diazmanuel/Nixie-Clock/Hardware/LED White Balance/WB-QBLP650.xlsx

Sheet: White balance
Datos del diseño
Vin (V) | 12
Lv Red (mcd) | 50
Tolerancia de las resistencias | 1%
Resultados
Lv Red [mcd] | 50
Lv Green [mcd] | 94.01363765
Lv Blue [mcd] | 13.44107946
If Red [mA] | 7.414908738
If Green [mA] | 2.053284319
If Blue [mA] | 2.033104411
Vf Red [V] | 2.266566315
Vf Green [V] | 2.287109717
Vf Blue [V] | 2.6160066
If White[mA] | 11.50129747
Pot White [mW] | 26.82108345
Lv White [mcd] | 157.4547171
Res Red [Ω] | 1312.684219
Res Green [Ω] | 4730.416626
Res Blue [Ω] | 4615.598368
Res N Red [Ω] | 1300
Res N Green [Ω] | 4750
Res N Blue [Ω] | 4640

Sheet: Datos Led
LED QBLP650 | If[mA] | Vf[V] | LAMDA[nm] | Iv[mcd]
Red | 20 | 2 | 620 | 140
True Green | 20 | 3.4 | 525 | 500
Blue | 20 | 3.1 | 470 | 100
 | Curva If-Vf |  |  |  |  | Curva If-Vf
if vs Vf | Red | Green | Blue |  | Lv vs If | Red | Green | Blue
If[mA] | Vf[V] | Vf[V] | Vf[V] |  | Relative Lv | If[mA] | If[mA] | If[mA]
0.1 | 1.8 | 1.8 | 1.8 |  | 0.01 | 0.01 | 0.01 | 0.01
1 | 1.96 | 2.1 | 2.68 |  | 0.1 | 2.45 | 1 | 1.55
2 | 2.07 | 2.42 | 2.8 |  | 0.2 | 4.45 | 2.19 | 3
3 | 2.14 | 2.47 | 2.85 |  | 0.3 | 6.32 | 3.42 | 4.77
4 | 2.17 | 2.54 | 2.87 |  | 0.4 | 8.26 | 4.9 | 6.71
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
