diazmanuel/Nixie-Clock/Software/NixieClock/Yakindu/nixie.png

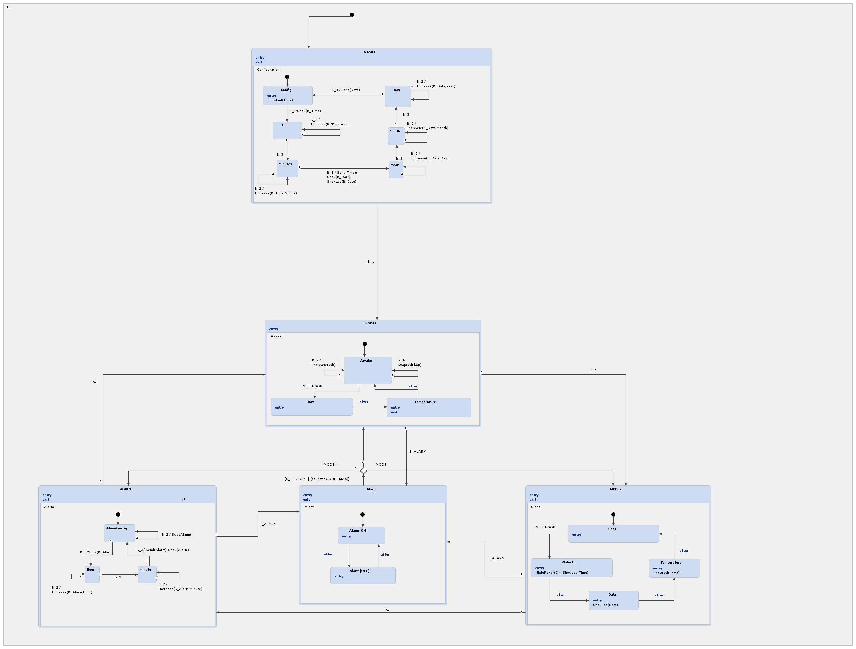
Software/NixieClock/Yakindu/nixie.png
