diazmanuel/Nixie-Clock/Hardware/3D Models/SW18 Parts/NixieClock.SLDASM

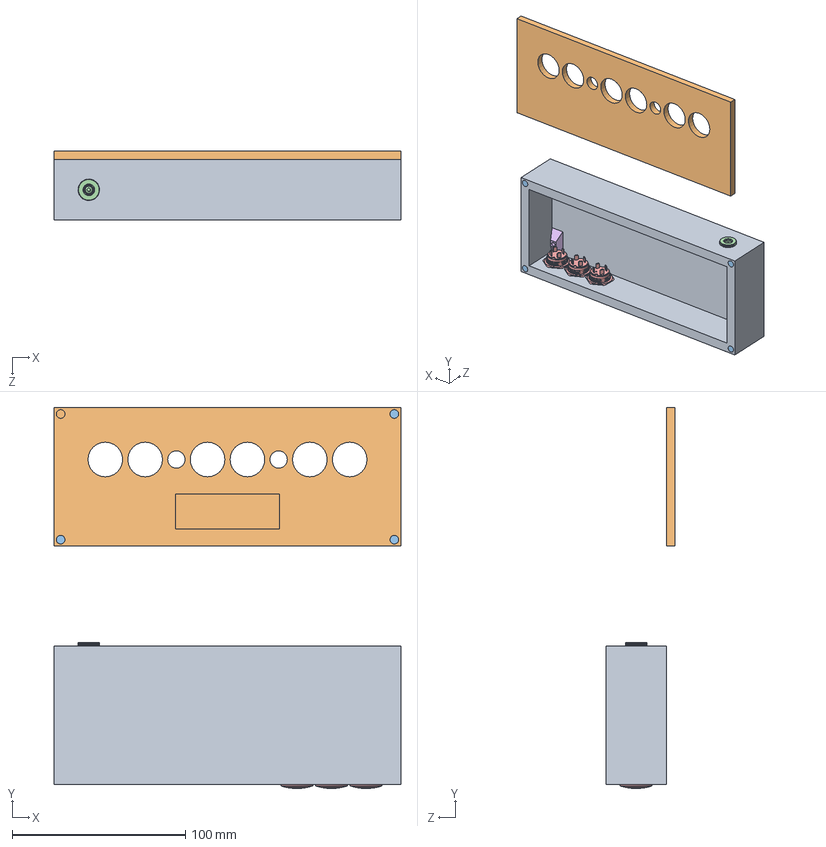
[picture p2: CAD file, 2020-05-14]
Hardware/3D Models/SW18 Parts/NixieClock.SLDASM
200.0 x 219.8 x 40.0 mm
caja
Acrilico
Iman x 8
Jack5.5x2.1
Button x 3
Pata x 2
