diazmanuel/Nixie-Clock/Hardware/3D Models/3D Print/Leg.STL

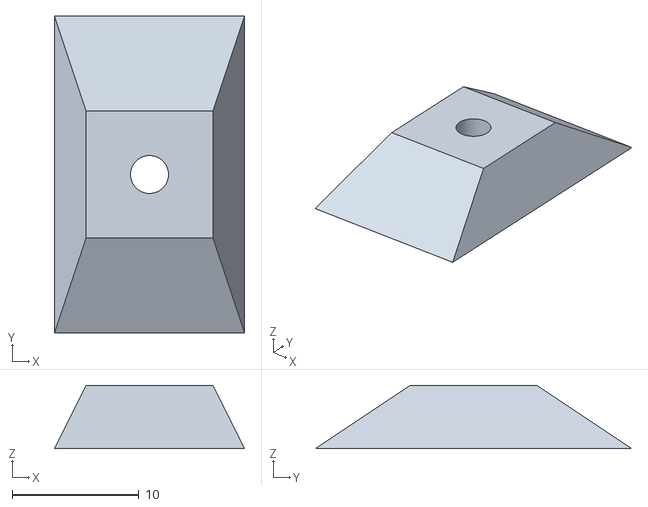
[picture p3: CAD file, 2021-12-26]
Hardware/3D Models/3D Print/Leg.STL
15.0 x 25.0 x 5.00
