diazmanuel/Nixie-Clock/Hardware/3D Models/SW18 Parts/Button.SLDPRT

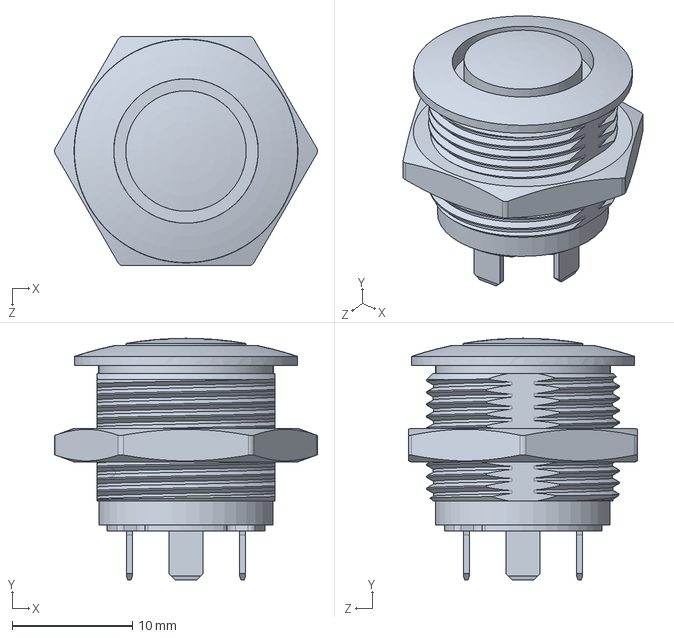
[picture p4: CAD file, 2021-12-26]
Hardware/3D Models/SW18 Parts/Button.SLDPRT
21.8 x 20.1 x 19.1 mm
