diazmanuel/Nixie-Clock/Hardware/3D Models/SW18 Parts/IN-14/NX-SZP-IN14-21-v02.SLDPRT

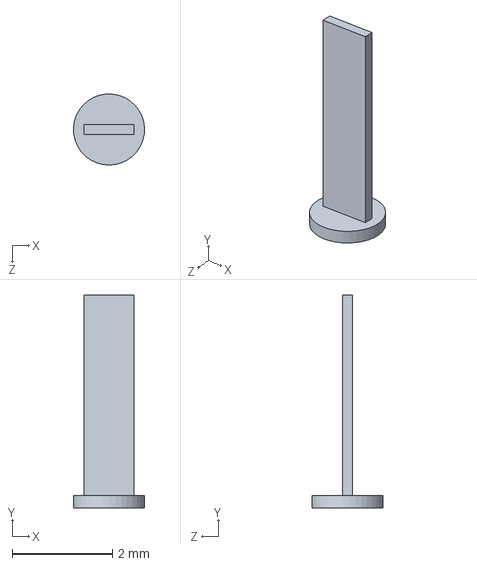
[picture p5: CAD file, 2020-05-14]
Hardware/3D Models/SW18 Parts/IN-14/NX-SZP-IN14-21-v02.SLDPRT
1.42 x 4.25 x 1.42 mm
