diazmanuel/Nixie-Clock/Hardware/3D Models/SW18 Parts/IN-3/NX-SZP-IN3-04-v01.SLDPRT

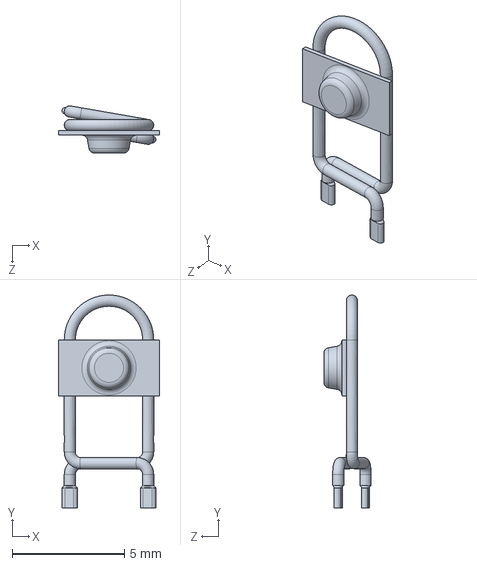
[picture p6: CAD file, 2020-05-14]
Hardware/3D Models/SW18 Parts/IN-3/NX-SZP-IN3-04-v01.SLDPRT
4.50 x 9.50 x 2.11 mm
