diazmanuel/Nixie-Clock/Hardware/3D Models/3D Print/PCB-SPC.STL

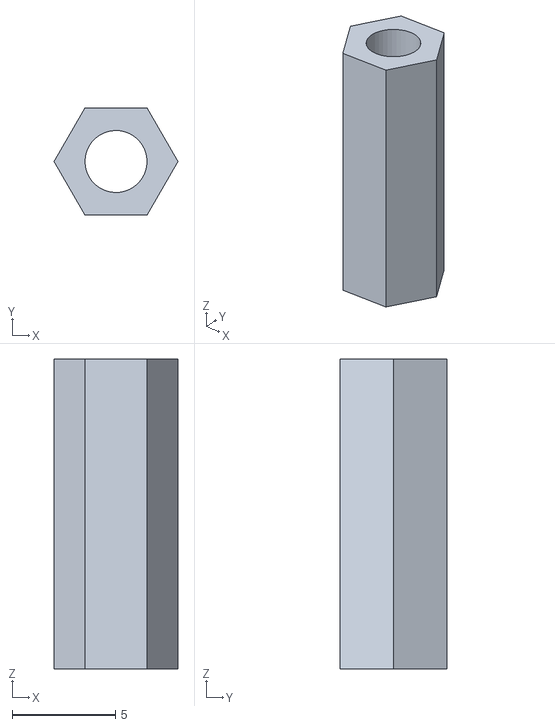
[picture p7: CAD file, 2021-12-26]
Hardware/3D Models/3D Print/PCB-SPC.STL
6.00 x 5.20 x 15.0
