diazmanuel/Nixie-Clock/Hardware/3D Models/SW18 Parts/IN-14/NX-SZP-IN14-20-v01.SLDPRT

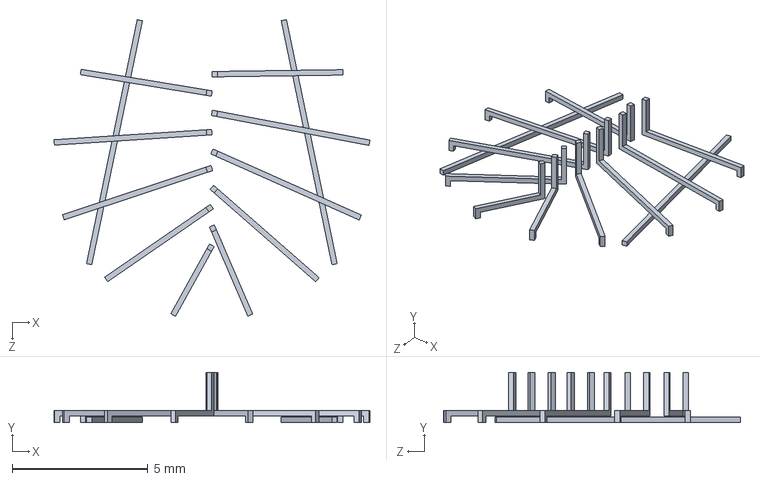
[picture p8: CAD file, 2020-05-14]
Hardware/3D Models/SW18 Parts/IN-14/NX-SZP-IN14-20-v01.SLDPRT
11.6 x 1.85 x 10.9 mm
