diazmanuel/Nixie-Clock/Hardware/3D Models/SW18 Parts/IN-3/NX-SZP-IN3-06-v01.SLDPRT

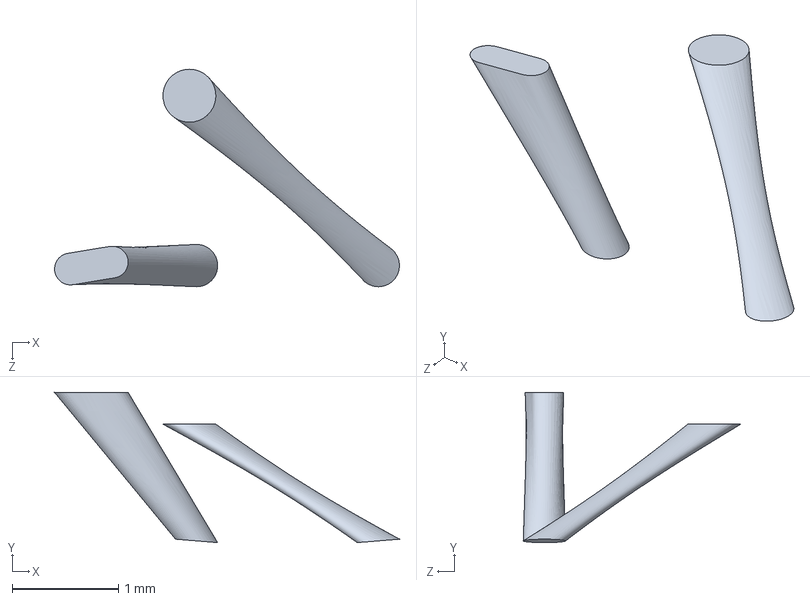
[picture p9: CAD file, 2020-05-14]
Hardware/3D Models/SW18 Parts/IN-3/NX-SZP-IN3-06-v01.SLDPRT
3.25 x 1.42 x 2.05 mm
