diazmanuel/Nixie-Clock/Hardware/3D Models/3D Print/NX-SPC-IN14.STL

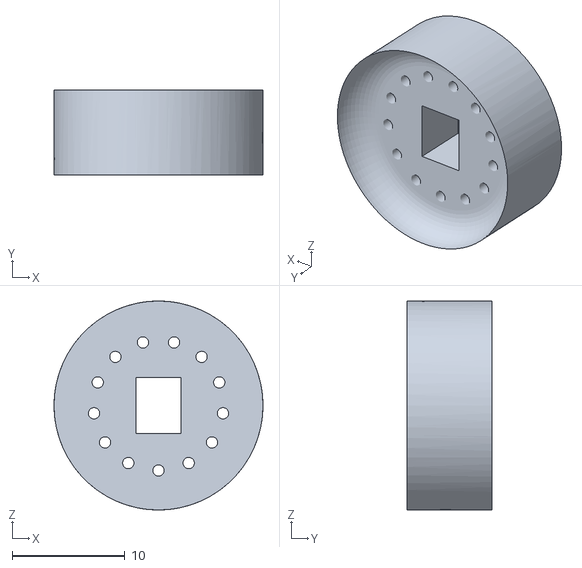
[picture p10: CAD file, 2021-05-01]
Hardware/3D Models/3D Print/NX-SPC-IN14.STL
18.5 x 7.50 x 18.5
