diazmanuel/Nixie-Clock/Hardware/3D Models/SW18 Parts/Acrylic.SLDPRT

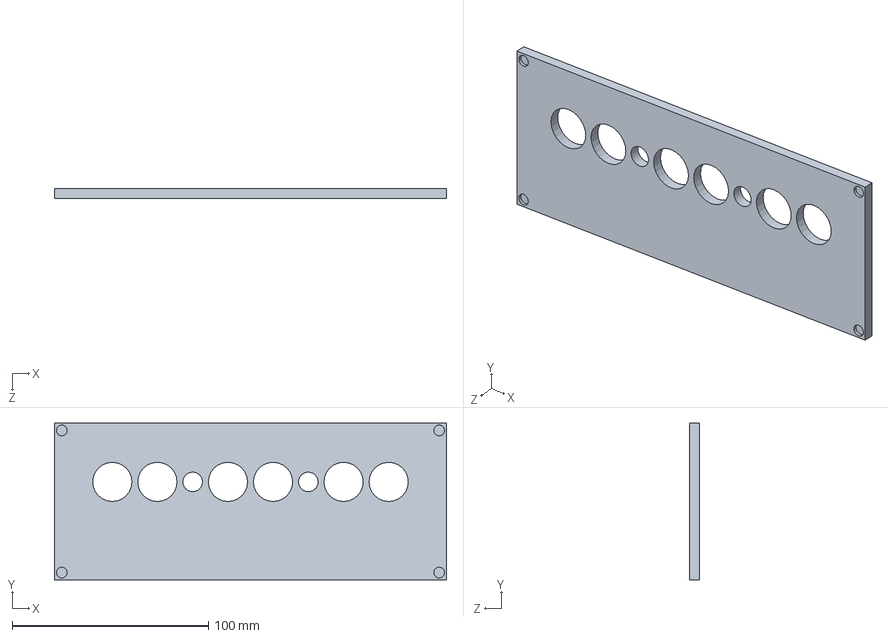
[picture p11: CAD file, 2021-12-26]
Hardware/3D Models/SW18 Parts/Acrylic.SLDPRT
200.0 x 80.0 x 5.00 mm
