diazmanuel/Nixie-Clock/Hardware/3D Models/SW18 Parts/IN-14/NX-SZP-IN14-01-v01.SLDPRT

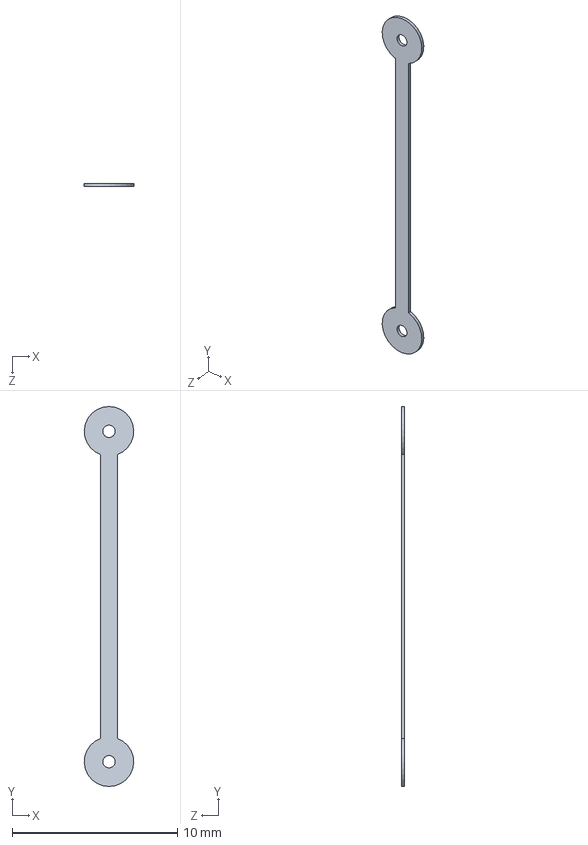
[picture p12: CAD file, 2020-05-14]
Hardware/3D Models/SW18 Parts/IN-14/NX-SZP-IN14-01-v01.SLDPRT
3.00 x 23.0 x 0.2 mm
