diazmanuel/Nixie-Clock/Hardware/3D Models/SW18 Parts/IN-3/NX-SZP-IN3-03-v01.SLDPRT

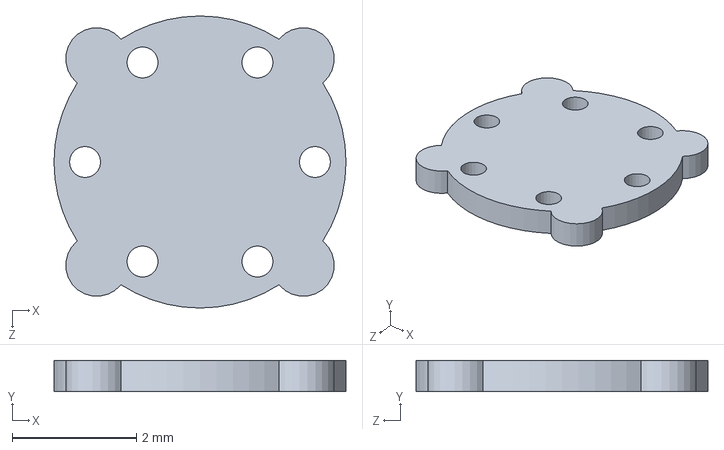
[picture p13: CAD file, 2020-05-14]
Hardware/3D Models/SW18 Parts/IN-3/NX-SZP-IN3-03-v01.SLDPRT
4.70 x 0.5 x 4.70 mm
