diazmanuel/Nixie-Clock/Hardware/3D Models/3D Print/NX-SPC-IN3.STL

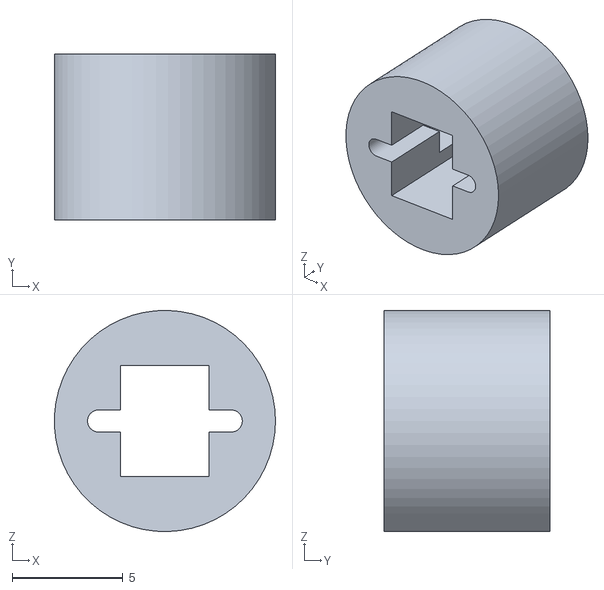
[picture p14: CAD file, 2021-05-01]
Hardware/3D Models/3D Print/NX-SPC-IN3.STL
9.99 x 7.50 x 10.00
