diazmanuel/Nixie-Clock/Hardware/3D Models/SW18 Parts/IN-3/NX-SZP-IN3-02-v01.SLDPRT

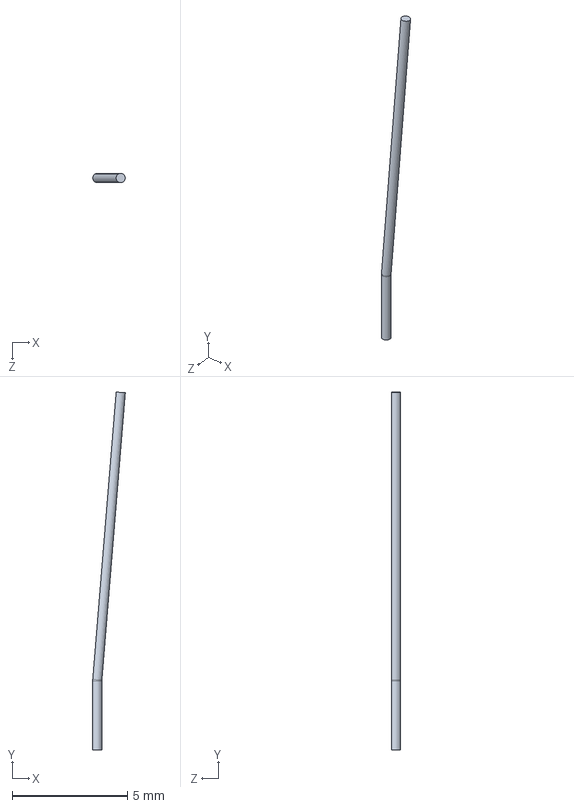
[picture p16: CAD file, 2020-05-14]
Hardware/3D Models/SW18 Parts/IN-3/NX-SZP-IN3-02-v01.SLDPRT
1.42 x 15.5 x 0.4 mm
