diazmanuel/Nixie-Clock/Hardware/3D Models/SW18 Parts/Box.SLDPRT

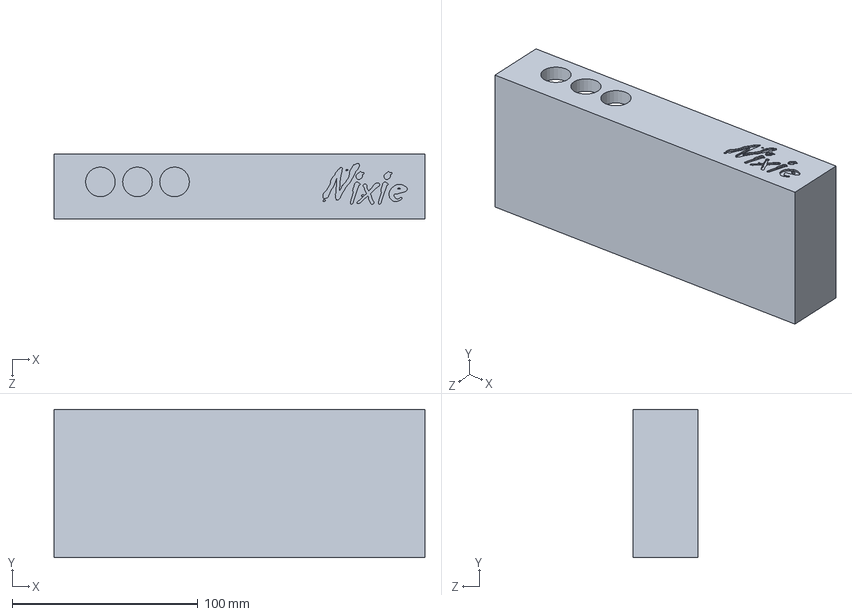
[picture p17: CAD file, 2021-12-26]
Hardware/3D Models/SW18 Parts/Box.SLDPRT
200.0 x 80.0 x 35.0 mm
