diazmanuel/Nixie-Clock/Hardware/3D Models/SW18 Parts/IN-14/NX-SZP-IN14-12-v01.SLDPRT

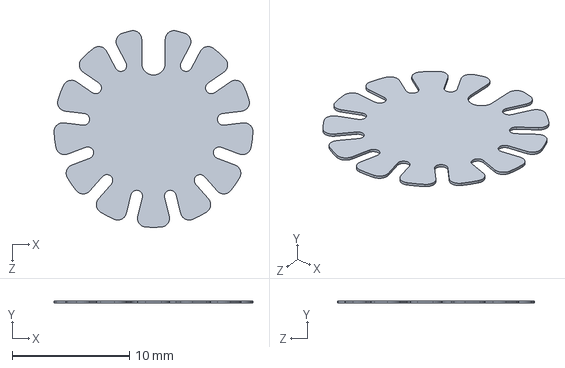
[picture p18: CAD file, 2020-05-14]
Hardware/3D Models/SW18 Parts/IN-14/NX-SZP-IN14-12-v01.SLDPRT
17.0 x 0.2 x 16.8 mm
