diazmanuel/Nixie-Clock/Hardware/3D Models/SW18 Parts/IN-3/NX-SZP-IN3-05-v01.SLDPRT

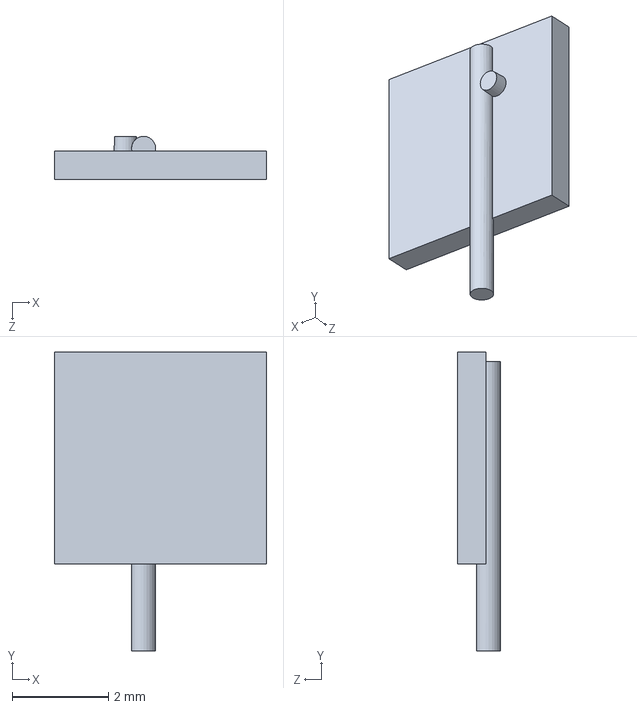
[picture p19: CAD file, 2020-05-14]
Hardware/3D Models/SW18 Parts/IN-3/NX-SZP-IN3-05-v01.SLDPRT
4.40 x 6.20 x 0.9 mm
