diazmanuel/Nixie-Clock/Hardware/3D Models/SW18 Parts/Magnet.SLDPRT

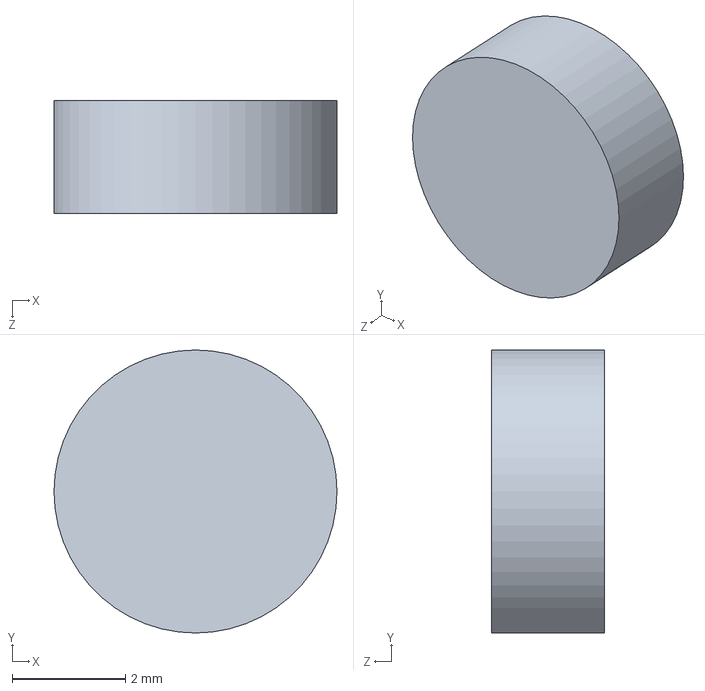
[picture p21: CAD file, 2021-12-26]
Hardware/3D Models/SW18 Parts/Magnet.SLDPRT
5.00 x 5.00 x 2.00 mm
