diazmanuel/Nixie-Clock/Hardware/3D Models/SW18 Parts/IN-14/NX-SZP-IN14-14-v01.SLDPRT

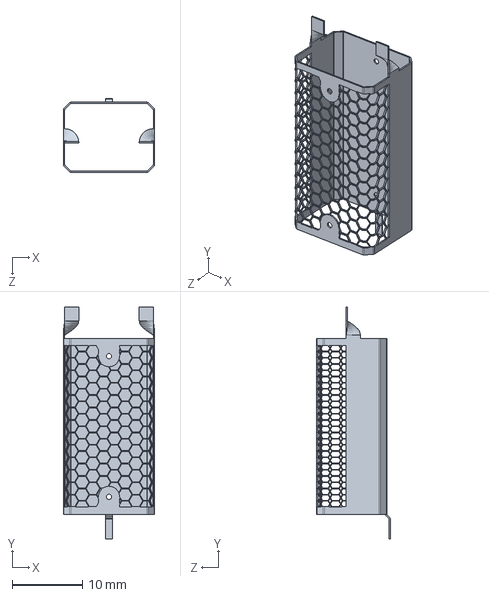
[picture p22: CAD file, 2020-05-14]
Hardware/3D Models/SW18 Parts/IN-14/NX-SZP-IN14-14-v01.SLDPRT
13.0 x 33.0 x 10.5 mm
