diazmanuel/Nixie-Clock/Hardware/3D Models/SW18 Parts/NX-IN14.SLDPRT

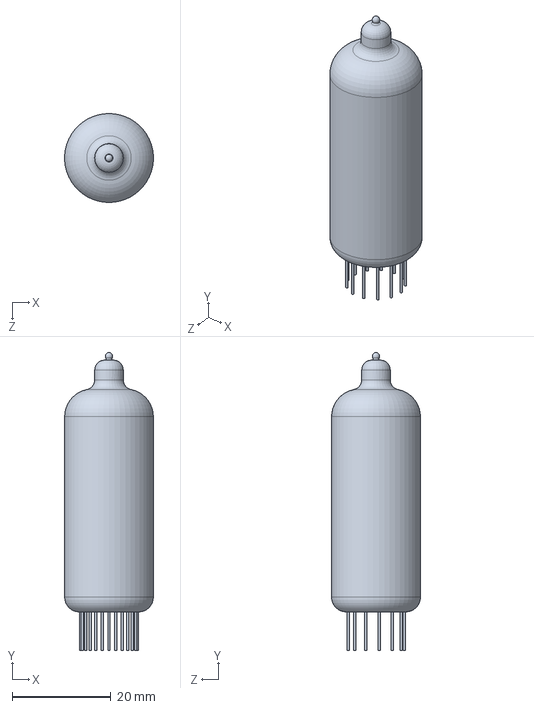
[picture p23: CAD file, 2021-12-26]
Hardware/3D Models/SW18 Parts/NX-IN14.SLDPRT
18.0 x 60.3 x 18.0 mm
