diazmanuel/Nixie-Clock/Hardware/3D Models/SW18 Parts/IN-14/NX-SZP-IN14-10-v01.SLDPRT

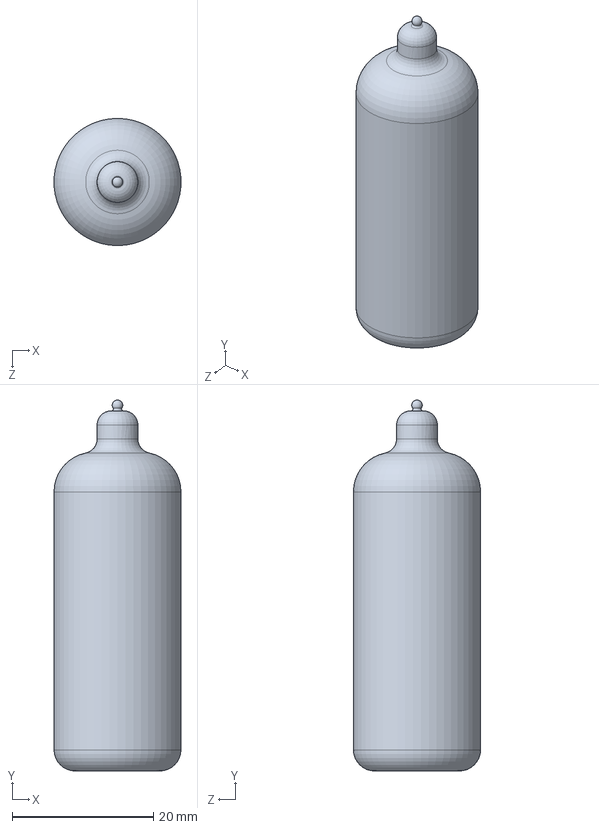
[picture p24: CAD file, 2020-05-14]
Hardware/3D Models/SW18 Parts/IN-14/NX-SZP-IN14-10-v01.SLDPRT
18.0 x 52.5 x 18.0 mm
