diazmanuel/Nixie-Clock/Hardware/3D Models/SW18 Parts/NX-IN3.SLDPRT

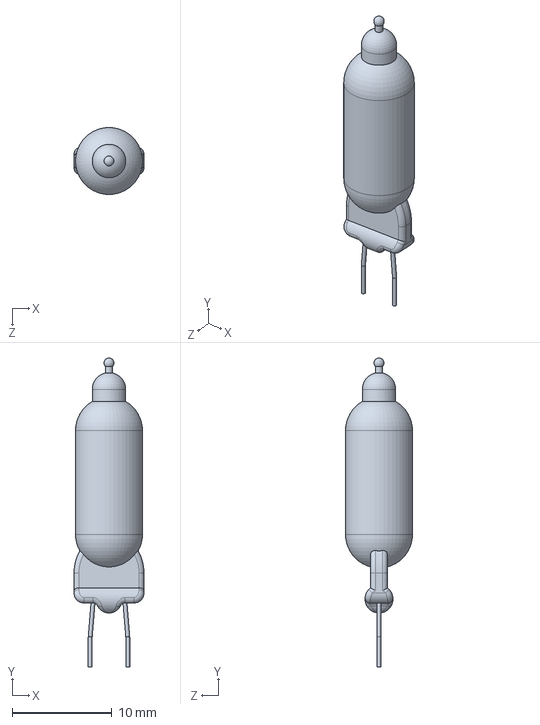
[picture p25: CAD file, 2021-12-26]
Hardware/3D Models/SW18 Parts/NX-IN3.SLDPRT
7.00 x 30.9 x 6.70 mm
