diazmanuel/Nixie-Clock/Hardware/3D Models/SW18 Parts/Jack5.5x2.1.SLDPRT

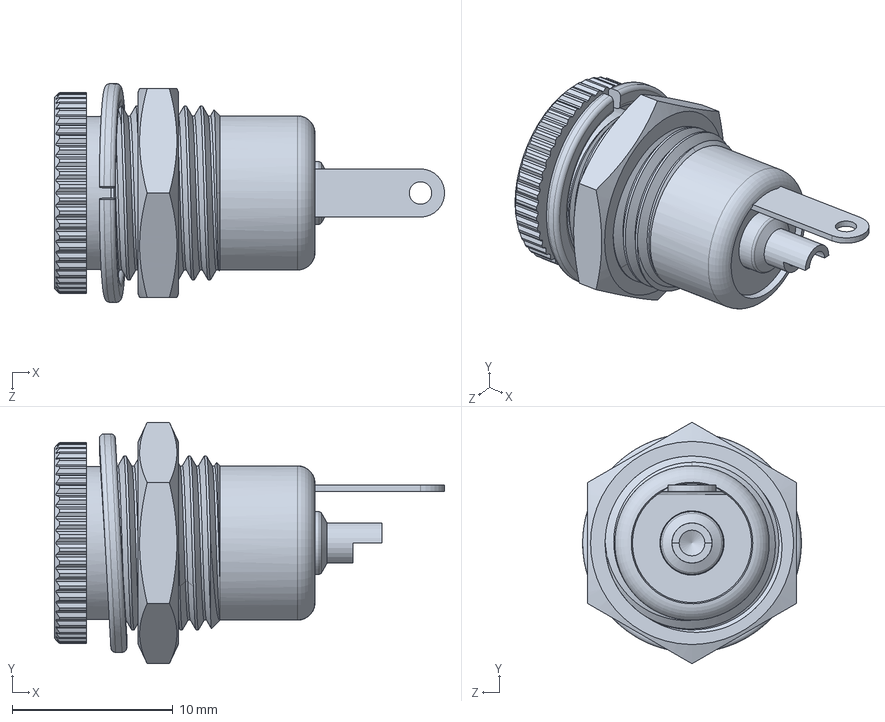
[picture p26: CAD file, 2021-12-26]
Hardware/3D Models/SW18 Parts/Jack5.5x2.1.SLDPRT
24.2 x 15.0 x 13.6 mm
