diazmanuel/Nixie-Clock/Hardware/3D Models/SW18 Parts/IN-14/NX-SZP-IN14-11-v01.SLDPRT

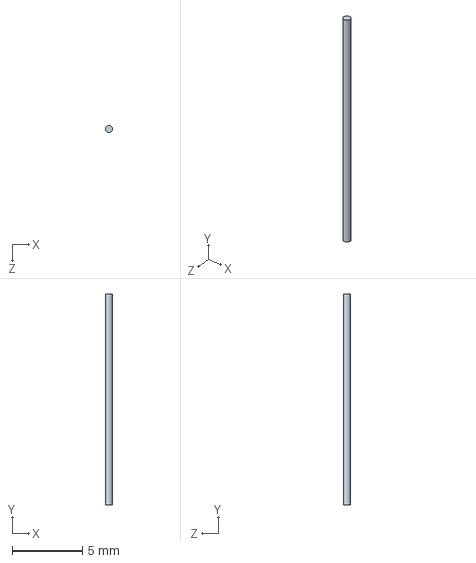
[picture p28: CAD file, 2020-05-14]
Hardware/3D Models/SW18 Parts/IN-14/NX-SZP-IN14-11-v01.SLDPRT
0.5 x 15.0 x 0.5 mm
