diazmanuel/Nixie-Clock/Hardware/3D Models/SW18 Parts/IN-14/NX-SZP-IN14-17-v01.SLDPRT

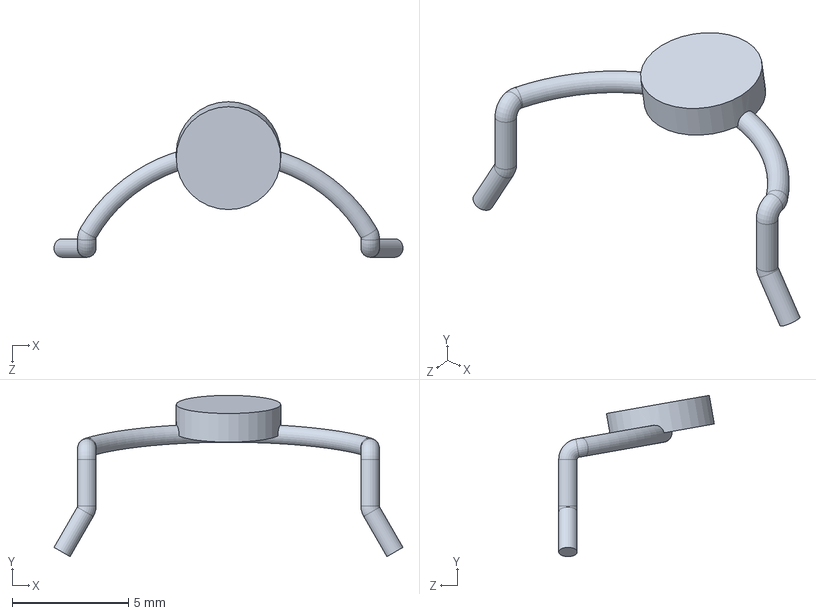
[picture p29: CAD file, 2020-05-14]
Hardware/3D Models/SW18 Parts/IN-14/NX-SZP-IN14-17-v01.SLDPRT
15.0 x 6.94 x 6.71 mm
