diazmanuel/Nixie-Clock/Hardware/3D Models/SW18 Parts/Nixie-Board-1.SLDPRT

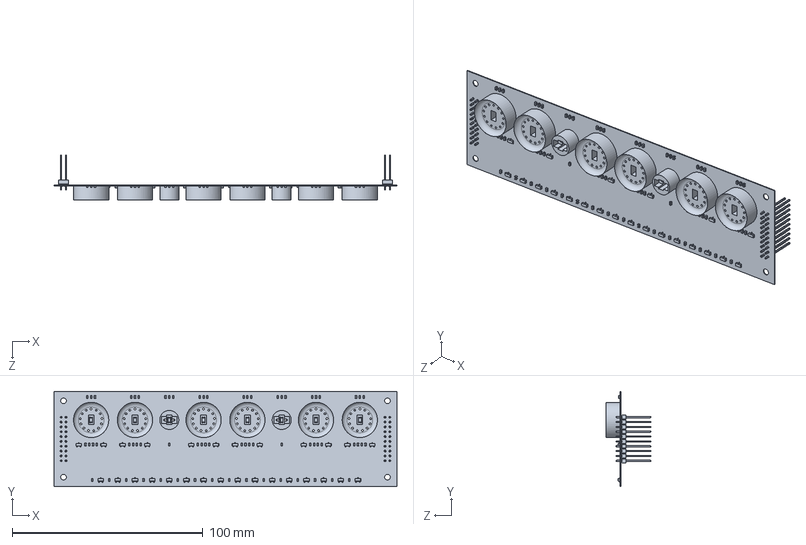
[picture p30: CAD file, 2020-05-15]
Hardware/3D Models/SW18 Parts/Nixie-Board-1.SLDPRT
180.0 x 50.0 x 23.8 mm
