diazmanuel/Nixie-Clock/Hardware/3D Models/SW18 Parts/IN-14/NX-SZP-IN14-18-v01.SLDPRT

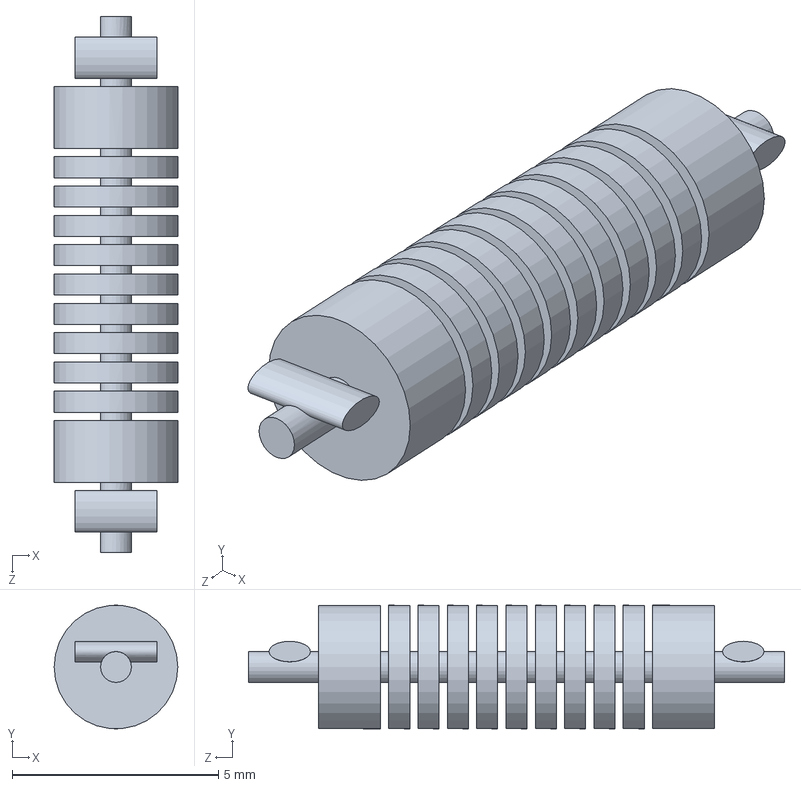
[picture p32: CAD file, 2020-05-14]
Hardware/3D Models/SW18 Parts/IN-14/NX-SZP-IN14-18-v01.SLDPRT
3.00 x 3.00 x 13.0 mm
