diazmanuel/Nixie-Clock/Hardware/3D Models/SW18 Parts/IN-14/NX-SZP-IN14-08-v01.SLDPRT

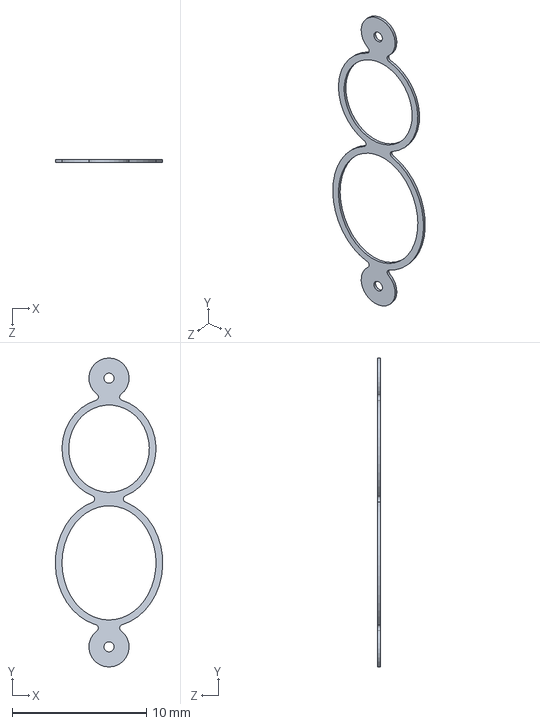
[picture p33: CAD file, 2020-05-14]
Hardware/3D Models/SW18 Parts/IN-14/NX-SZP-IN14-08-v01.SLDPRT
8.00 x 23.0 x 0.2 mm
