diazmanuel/Nixie-Clock/Hardware/3D Models/SW18 Parts/IN-14/NX-SZP-IN14-16-v01.SLDPRT

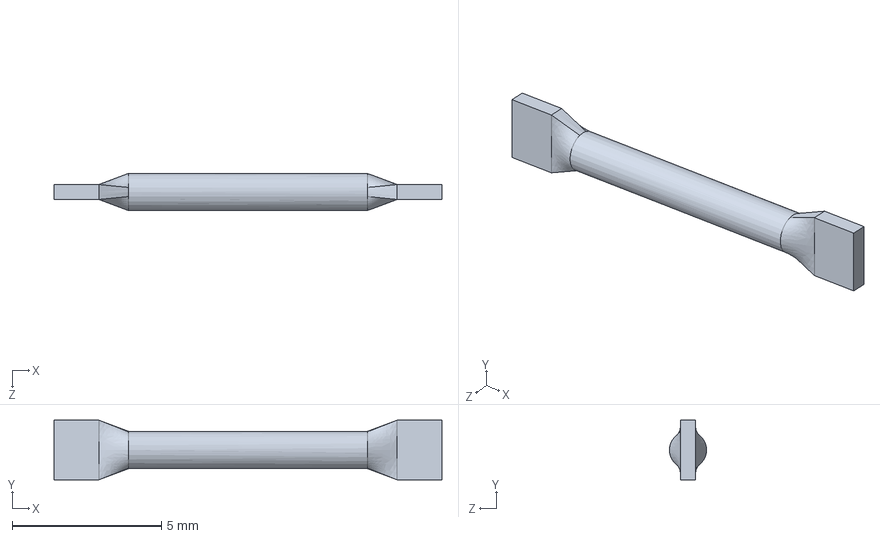
[picture p34: CAD file, 2020-05-14]
Hardware/3D Models/SW18 Parts/IN-14/NX-SZP-IN14-16-v01.SLDPRT
13.0 x 2.00 x 1.25 mm
