diazmanuel/Nixie-Clock/Hardware/3D Models/SW18 Parts/IN-14/NX-SZP-IN14-09-v01.SLDPRT

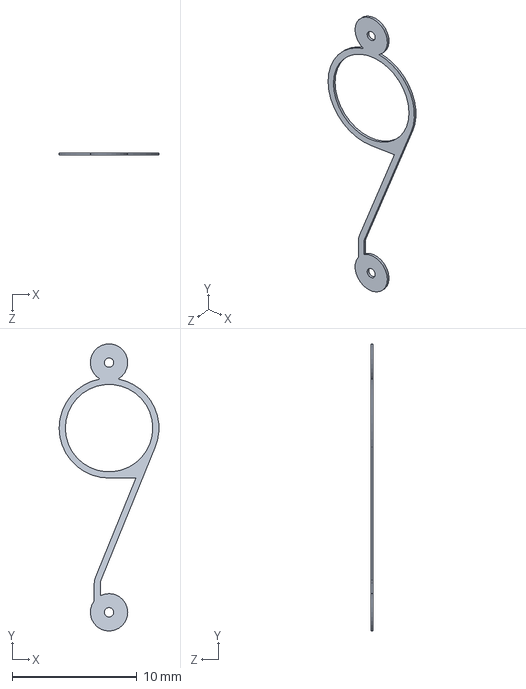
[picture p35: CAD file, 2020-05-14]
Hardware/3D Models/SW18 Parts/IN-14/NX-SZP-IN14-09-v01.SLDPRT
7.99 x 23.0 x 0.2 mm
