diazmanuel/Nixie-Clock/Hardware/3D Models/SW18 Parts/IN-14/NX-SZP-IN14-19-v01.SLDPRT

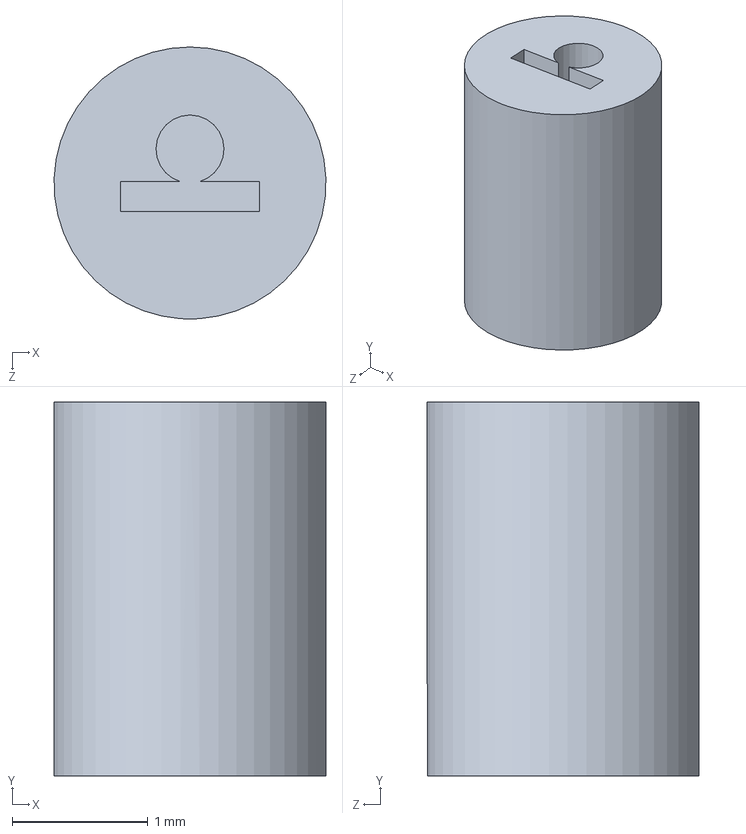
[picture p36: CAD file, 2020-05-14]
Hardware/3D Models/SW18 Parts/IN-14/NX-SZP-IN14-19-v01.SLDPRT
2.00 x 2.75 x 2.00 mm
