diazmanuel/Nixie-Clock/Hardware/3D Models/SW18 Parts/IN-14/NX-SZP-IN14-13-v01.SLDPRT

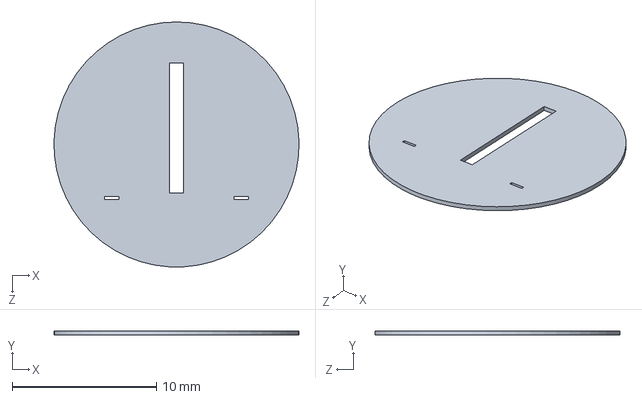
[picture p37: CAD file, 2020-05-14]
Hardware/3D Models/SW18 Parts/IN-14/NX-SZP-IN14-13-v01.SLDPRT
17.0 x 0.3 x 17.0 mm
