diazmanuel/Nixie-Clock/Hardware/3D Models/SW18 Parts/IN-14/NX-SZP-IN14-15-v01.SLDPRT

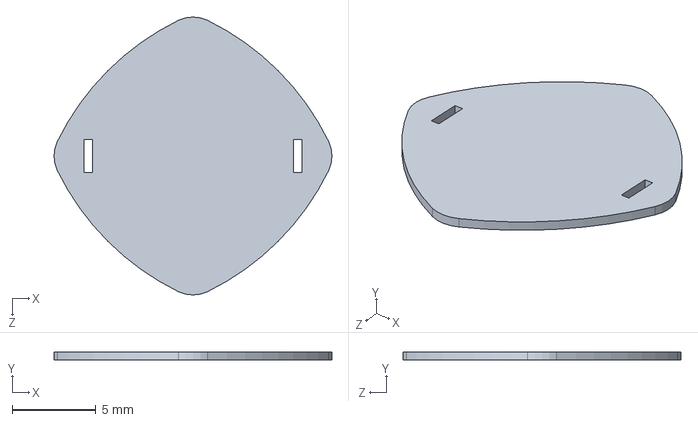
[picture p38: CAD file, 2020-05-14]
Hardware/3D Models/SW18 Parts/IN-14/NX-SZP-IN14-15-v01.SLDPRT
16.6 x 0.5 x 16.6 mm
