diazmanuel/Nixie-Clock/(list of files, cad)

Other CAD files:
Hardware/3D Models/SW18 Parts/PCB-SPC.SLDPRT
Hardware/3D Models/SW18 Parts/Leg.SLDPRT
Hardware/3D Models/SW18 Parts/NX-SPC-IN14.SLDPRT
Hardware/3D Models/SW18 Parts/NX-SPC-IN3.SLDPRT
Hardware/3D Models/SW18 Parts/IN-14/NX-SZP-IN14-06-v01.SLDPRT
Hardware/3D Models/SW18 Parts/IN-14/NX-SZP-IN14-21-v01.SLDPRT
Hardware/PCB/Outputs/NixieClock_B1.x_t
