diazmanuel/Nixie-Clock/Hardware/PCB/Outputs/NixieClock_B1.pdf

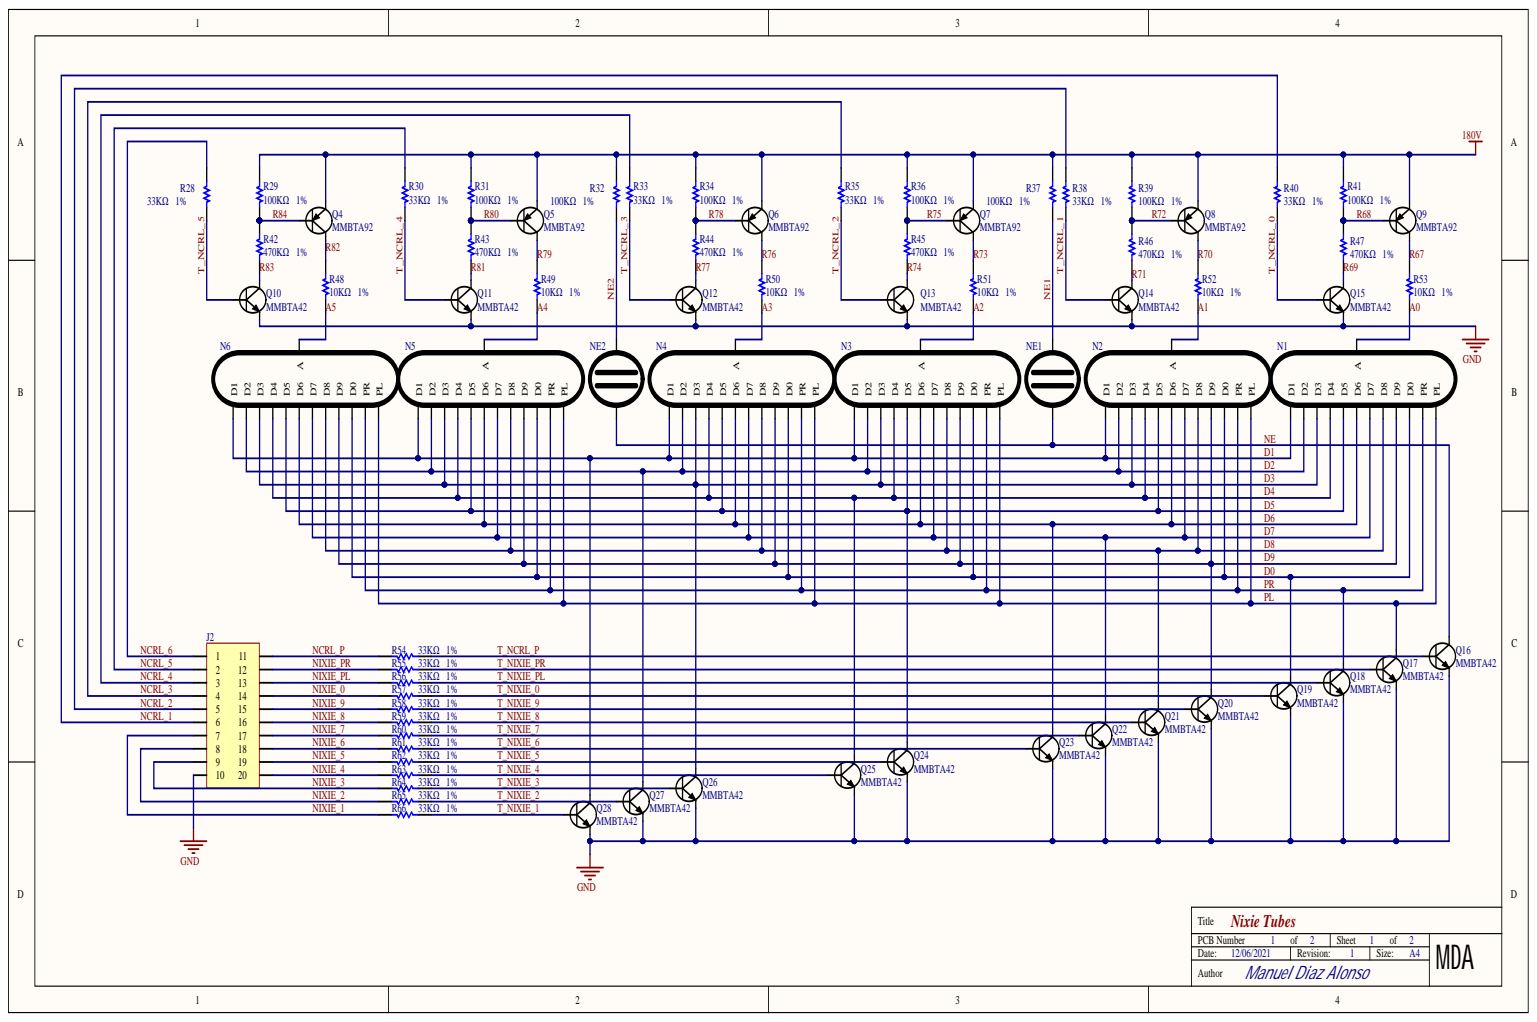
[picture p41: page 1]

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
T_NCRL_P

7 17 | NIXIE_7 R60 33KΩ 1% T_NIXIE_7
8 18 | NIXIE_6 | R61 33KΩ 1% T_NIXIE_6
9 19 | NIXIE_5 | R62 33KΩ 1% T_NIXIE_5
10 20 | NIXIE_4 | R63 33KΩ 1% T_NIXIE_4

NIXIE_3 | R64 33KΩ 1% T_NIXIE_3
NIXIE_2 | R65 33KΩ 1% T_NIXIE_2
NIXIE_1 | R66 33KΩ 1% T_NIXIE_1

PCB Number 1 of | Sheet 1 2
Date: 12/06/2021 | Revision: 1 | Size:

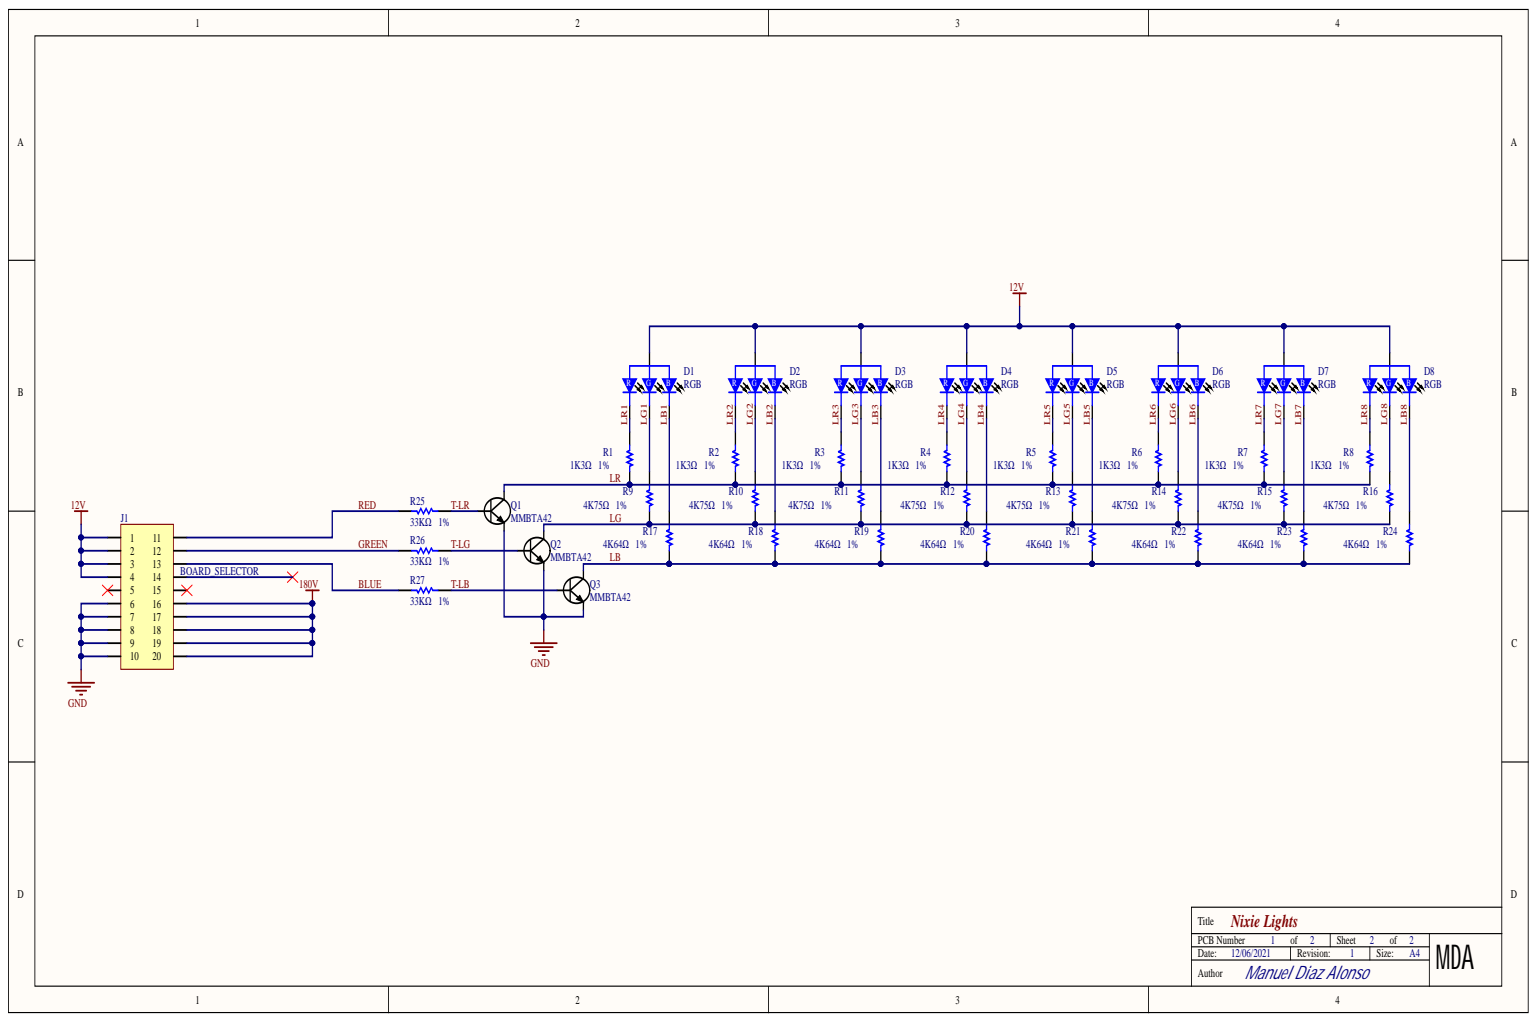
[picture p42: page 2]

PCB Number of 2 | Sheet 2 of 2
Date: 12/06/2021 | Revision: 1 | Size:

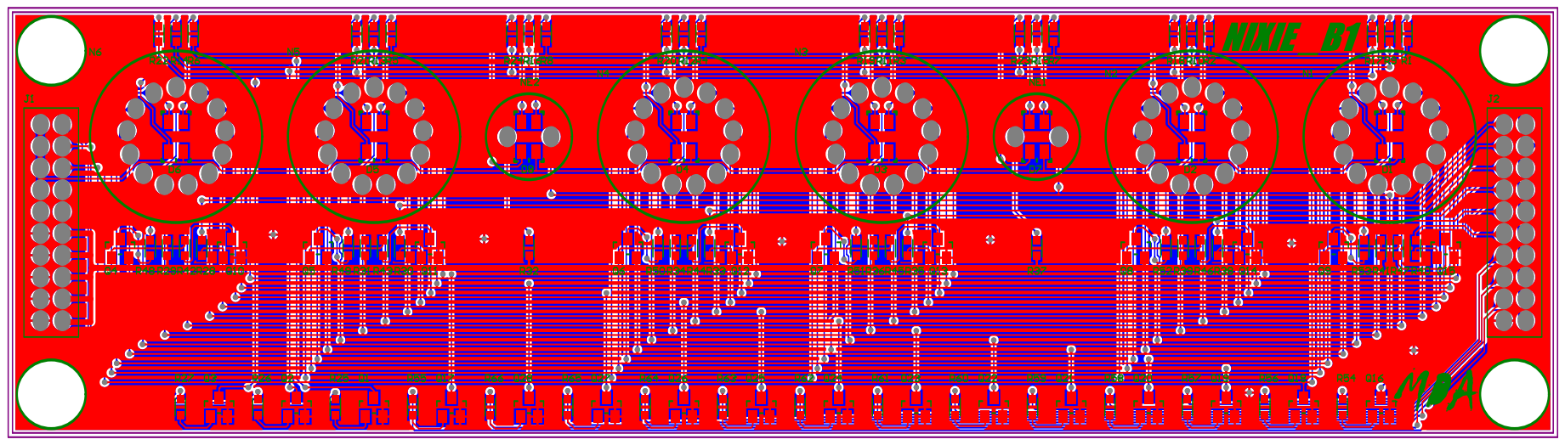
[picture p43: page 3]

Item # | LibRef | Comment | Description | Footprint | Quantity
1 | RGB | RGB | qblp655-rgb | 1210-RGB | 8
2 | PIN_2X10 | PIN_2X10 | TSW-110-15-F-D-LL | PIN_2X10_HDR | 2
3 | NIXIE-IN14 | NIXIE-IN14 | | NIXIE_IN-14 | 6
4 | NIXIE-IN3 | NIXIE-IN3 | | NIXIE_IN-3 | 2
5 | NPN | MMBTA42 | | SOT-23 | 22
6 | PNP | MMBTA92 | | SOT-23 | 6
7 | RES | 1K3Ω 1% | | 0603 | 8
8 | RES | 4K75Ω 1% | | 0603 | 8
9 | RES | 4K64Ω 1% | | 0603 | 8
10 | RES | 33KΩ 1% | | 0603 | 22
11 | RES | 100KΩ 1% | | 0603 | 8
12 | RES | 470KΩ 1% | | 0603 | 6
13 | RES | 10KΩ 1% | | 0603 | 6
