diazmanuel/Nixie-Clock/Hardware/HV Simulation/HV.asc

Cin: cap; 220µ; Rser=1.5
Cout: cap; 2.2µ; V=400 Rser=1.5
CT: cap; 0.87nF
D1: diode; DI_US1G
D2: diode; BAS16H
ILoad: load2; {I}
L1: ind; 220µ; Ipk=1.24 Rser=0.305
M1: nmos; irf644S
Q1: pnp; DI_MMBTA92
R1: res; 4K7
R2: res; 680k
Rg: res; 1k
RS: res; 10m
U1: MC34063
Vs: voltage; 12
Named nets: 0, Vref, Vo, Vcrl, Vd, vg, Vin, Vs
.tran 0 {tstop} {tsave} {timestep} uic
.inc Lib\\MC34063.lib
.inc Lib\\IRF644.lib
.inc Lib\\US1G.lib
.inc Lib\\MMBTA92.lib
.inc Lib\\MMBTA42.lib
.inc Lib\\BAS16H.lib
.param t=20ms
.param tsave=0ms
.param toffset=10ms
.param tstop= t
.param npoints=1000
.param timestep=t/npoints
.step param I list 0m 1m 2.5m 5m 10m 20m 40m 50m 60m 70m
.meas TRAN Vo AVG V(vo) TRIG time=toffset TARG time=t
.meas TRAN Vs AVG V(vs) TRIG time=toffset TARG time=t
.meas TRAN Irs AVG -I(Rs) TRIG time=toffset TARG time=t
.meas TRAN Iload AVG I(Iload) TRIG time=toffset TARG time=t
.meas TRAN Pout AVG (V(vo)*I(ILoad)) TRIG time=toffset TARG time=t
.meas TRAN Pin AVG (-I(Rs)*V(vs)) TRIG time=toffset TARG time=t
.meas TRAN Pdio AVG (V(Vd,Vo)*I(D1)) TRIG time=toffset TARG time=t
.meas TRAN Pmos AVG (V(vd)*Ix(M1:D)) TRIG time=toffset TARG time=t
.meas TRAN Pcout AVG (I(Cout)*V(vo)) TRIG time=toffset TARG time=t
.meas TRAN Pind AVG (I(L1)*V(vd,vin)) TRIG time=toffset TARG time=t
.meas Eff PARAM (Pout/Pin)*100
.meas PerMos PARAM (Pmos/Pin)*100
.meas PerDio PARAM (Pdio/Pin)*100
.meas PerCout PARAM (Pcout/Pin)*100
.meas PerInd PARAM (Pind/Pin)*100
