diazmanuel/Nixie-Clock/(list of files, drawings)

Other design files:
Hardware/PCB/Projects/NixieClock_B1/nixie_light.SchDoc
Hardware/PCB/Projects/NixieClock_B1/nixie_tube.SchDoc
Hardware/PCB/Projects/NixieClock_B1/NixieClock_B1.PrjPcb
Hardware/PCB/Projects/NixieClock_B2/nixie_peripherals.SchDoc
Hardware/PCB/Projects/NixieClock_B2/nixie_power.SchDoc
Hardware/PCB/Projects/NixieClock_B2/NixieClock_B2.PrjPcb
