diazmanuel/Nixie-Clock/Software/NixieClock/Src/main.c

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
/* Includes ------------------------------------------------------------------*/
#include "main.h"
#include "cmsis_os.h"

/* USER CODE BEGIN Includes */
#include "nixieDisplay.h"
/* USER CODE END Includes */

/* USER CODE BEGIN PD */
#define B_PERIOD 8
#define B_ACTIVITY 4
#define RTC_PERIOD 2
/* USER CODE END PD */

I2C_HandleTypeDef hi2c2;
DMA_HandleTypeDef hdma_i2c2_rx;

TIM_HandleTypeDef htim2;
TIM_HandleTypeDef htim3;
TIM_HandleTypeDef htim4;

osThreadId pullingHandle;
osThreadId ButtonsHandle;
osThreadId AlarmHandle;
osMessageQId Q_ButtonsHandle;
osSemaphoreId S_AlarmHandle;
/* USER CODE BEGIN PV */
uint8_t buttonFlag[6]={0,0,0,0,0,0};
/* USER CODE END PV */

void SystemClock_Config(void);
static void MX_GPIO_Init(void);
static void MX_DMA_Init(void);
static void MX_TIM2_Init(void);
static void MX_TIM3_Init(void);
static void MX_I2C2_Init(void);
static void MX_TIM4_Init(void);
void StartPullingTask(void const * argument);
void StartButtosTask(void const * argument);
void StartAlarmTask(void const * argument);

/* USER CODE BEGIN 0 */
uint8_t event(){
	uint8_t aux=0,aux2=0;
	static uint8_t start[6]={0,1,1,1,0,1};
	if((HAL_GPIO_ReadPin(B1_GPIO_Port,B1_Pin))==GPIO_PIN_RESET){
		if(!buttonFlag[E_B1]){
			aux=E_B1;
			if(start[E_B1]){
				buttonFlag[E_B1]=20;
				start[E_B1]=0;
			}else{
				buttonFlag[E_B1]=1;
			}
		}
	}else{
		buttonFlag[E_B1]=0;
		start[E_B1]=1;
	}
	if((HAL_GPIO_ReadPin(B2_GPIO_Port,B2_Pin))==GPIO_PIN_RESET){
		if(!buttonFlag[E_B2]){
			aux=E_B2;
			if(start[E_B2]){
				buttonFlag[E_B2]=20;
				start[E_B2]=0;
			}else{
				buttonFlag[E_B2]=1;
			}
		}
	}else{
		buttonFlag[E_B2]=0;
		start[E_B2]=1;
	}
	if((HAL_GPIO_ReadPin(B3_GPIO_Port,B3_Pin))==GPIO_PIN_RESET){
		if(!buttonFlag[E_B3]){
			aux=E_B3;
			if(start[E_B3]){
				buttonFlag[E_B3]=20;
				start[E_B3]=0;
			}else{
				buttonFlag[E_B3]=1;
			}
		}
	}else{
		buttonFlag[E_B3]=0;
		start[E_B3]=1;
	}
	aux2= HAL_GPIO_ReadPin(SENSOR_GPIO_Port,SENSOR_Pin);
	if(aux2!=start[E_SENSOR]){
		if(!buttonFlag[E_SENSOR]){
			start[E_SENSOR]=!start[E_SENSOR];
			aux=E_SENSOR;
			buttonFlag[E_SENSOR]=10;
		}
	}
	return aux;
}
/* USER CODE END 0 */

/**
  * @brief  The application entry point.
  * @retval int
  */
int main(void)
{
  /* MCU Configuration--------------------------------------------------------*/

  /* Reset of all peripherals, Initializes the Flash interface and the Systick. */
  HAL_Init();

  /* USER CODE BEGIN Init */
  resetGpio();
  /* USER CODE END Init */

  /* Configure the system clock */
  SystemClock_Config();

  /* Initialize all configured peripherals */
  MX_GPIO_Init();
  MX_DMA_Init();
  MX_TIM2_Init();
  MX_TIM3_Init();
  MX_I2C2_Init();
  MX_TIM4_Init();
  /* USER CODE BEGIN 2 */
  nixieInit();
  /* USER CODE END 2 */

  /* USER CODE BEGIN RTOS_MUTEX */
  /* add mutexes, ... */
  /* USER CODE END RTOS_MUTEX */

  /* Create the semaphores(s) */
  /* definition and creation of S_Alarm */
  osSemaphoreDef(S_Alarm);
  S_AlarmHandle = osSemaphoreCreate(osSemaphore(S_Alarm), 1);

  /* USER CODE BEGIN RTOS_SEMAPHORES */
  /* add semaphores, ... */
  /* USER CODE END RTOS_SEMAPHORES */

  /* USER CODE BEGIN RTOS_TIMERS */
  /* start timers, add new ones, ... */
  /* USER CODE END RTOS_TIMERS */

  /* Create the queue(s) */
  /* definition and creation of Q_Buttons */
  osMessageQDef(Q_Buttons, 4, uint8_t);
  Q_ButtonsHandle = osMessageCreate(osMessageQ(Q_Buttons), NULL);

  /* USER CODE BEGIN RTOS_QUEUES */
  /* add queues, ... */
  /* USER CODE END RTOS_QUEUES */

  /* Create the thread(s) */
  /* definition and creation of pulling */
  osThreadDef(pulling, StartPullingTask, osPriorityHigh, 0, 128);
  pullingHandle = osThreadCreate(osThread(pulling), NULL);

  /* definition and creation of Buttons */
  osThreadDef(Buttons, StartButtosTask, osPriorityBelowNormal, 0, 128);
  ButtonsHandle = osThreadCreate(osThread(Buttons), NULL);

  /* definition and creation of Alarm */
  osThreadDef(Alarm, StartAlarmTask, osPriorityNormal, 0, 128);
  AlarmHandle = osThreadCreate(osThread(Alarm), NULL);

  /* USER CODE BEGIN RTOS_THREADS */

  /* add threads, ... */
  /* USER CODE END RTOS_THREADS */

  /* Start scheduler */
  osKernelStart();

  /* We should never get here as control is now taken by the scheduler */
  /* Infinite loop */
  /* USER CODE BEGIN WHILE */
  while (1)
  {
    /* USER CODE END WHILE */

    /* USER CODE BEGIN 3 */
  }
  /* USER CODE END 3 */
}

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
/* USER CODE BEGIN 4 */
void HAL_GPIO_EXTI_Callback(uint16_t GPIO_Pin){
	portBASE_TYPE X	=pdFALSE;
	if(GPIO_Pin==GPIO_PIN_1){
		xSemaphoreGiveFromISR(S_AlarmHandle,&X);
	}
	portEND_SWITCHING_ISR(X);
}
void HAL_I2C_MemRxCpltCallback(I2C_HandleTypeDef *hi2c){
	if(hi2c->Instance==hi2c2.Instance){
		loadRTC();
	}
}


/* USER CODE END 4 */

/* USER CODE BEGIN Header_StartPullingTask */
/**
  * @brief  Function implementing the pulling thread.
  * @param  argument: Not used 
  * @retval None
  */
/* USER CODE END Header_StartPullingTask */
void StartPullingTask(void const * argument)
{
  /* USER CODE BEGIN 5 */

  /* Infinite loop */
	uint8_t aux=0;
  for(;;)
  {
	  aux=event();
	  if(aux){
	  xQueueSendToBack(Q_ButtonsHandle,&aux,(portTickType)0);
	  }
    osDelay(100);
  }
  /* USER CODE END 5 */
}

/* USER CODE BEGIN Header_StartButtosTask */
/**
* @brief Function implementing the Buttons thread.
* @param argument: Not used
* @retval None
*/
/* USER CODE END Header_StartButtosTask */
void StartButtosTask(void const * argument)
{
  /* USER CODE BEGIN StartButtosTask */
	uint8_t aux=0;
  /* Infinite loop */
  for(;;)
  {
		xQueueReceive(Q_ButtonsHandle,&aux,portMAX_DELAY);
		nixieEvent(aux);
  }
  /* USER CODE END StartButtosTask */
}

/* USER CODE BEGIN Header_StartAlarmTask */
/**
* @brief Function implementing the Alarm thread.
* @param argument: Not used
* @retval None
*/
/* USER CODE END Header_StartAlarmTask */
void StartAlarmTask(void const * argument)
{
  /* USER CODE BEGIN StartAlarmTask */
  /* Infinite loop */
  for(;;)
  {
    xSemaphoreTake(S_AlarmHandle,portMAX_DELAY);
    nixieEvent(E_ALARM);
  }
  /* USER CODE END StartAlarmTask */
}

 /**
  * @brief  Period elapsed callback in non blocking mode
  * @note   This function is called  when TIM1 interrupt took place, inside
  * HAL_TIM_IRQHandler(). It makes a direct call to HAL_IncTick() to increment
  * a global variable "uwTick" used as application time base.
  * @param  htim : TIM handle
  * @retval None
  */
void HAL_TIM_PeriodElapsedCallback(TIM_HandleTypeDef *htim)
{
  /* USER CODE BEGIN Callback 0 */
	static uint8_t aux=0,aux2=0;
  /* USER CODE END Callback 0 */
  if (htim->Instance == TIM1) {
    HAL_IncTick();
  }
  /* USER CODE BEGIN Callback 1 */
  if (htim->Instance == TIM2){
	  //base freq =72 Mhz
	  //precaler 17999
	  //counter 499
	  //per int = (18000/72M)*500 = 125ms
     nixieBuzzer(B_PERIOD,B_ACTIVITY);
  }
  if(htim->Instance == TIM3){
	  //base freq =72 Mhz
	  //precaler 999
	  //counter 71
	  //per int = (1000/72M)*72 = 1ms
	  nixieTickUpdate();
  }
  if(htim->Instance==TIM4){
	  //base freq =72 Mhz
	  //precaler 99
	  //counter 143
	  //period int = (100/72M)*144 = 200us
	 if (!aux){
		//period = 500ms
		getRTC(&hi2c2);
	 }

	 if(!aux2){
		//period = 100ms
		if(buttonFlag[E_B1]){
			buttonFlag[E_B1]--;
		}
		if(buttonFlag[E_B2]){
			buttonFlag[E_B2]--;
		}
		if(buttonFlag[E_B3]){
			buttonFlag[E_B3]--;
		}
		if(buttonFlag[E_SENSOR]){
			buttonFlag[E_SENSOR]--;
		}
	 }
	 nixieDisplay(); //periodo de 200us * 10 = 2ms con duty 10%
	 nixieLed();
	 aux++;
	 aux2++;
	 aux2%=500;
	 aux%=2500;
  }

  /* USER CODE END Callback 1 */
}

/**
  * @brief  This function is executed in case of error occurrence.
  * @retval None
  */
void Error_Handler(void)
{
  /* USER CODE BEGIN Error_Handler_Debug */
  /* User can add his own implementation to report the HAL error return state */

  /* USER CODE END Error_Handler_Debug */
}

#ifdef  USE_FULL_ASSERT
/**
  * @brief  Reports the name of the source file and the source line number
  *         where the assert_param error has occurred.
  * @param  file: pointer to the source file name
  * @param  line: assert_param error line source number
  * @retval None
  */
void assert_failed(uint8_t *file, uint32_t line)
{
  /* USER CODE BEGIN 6 */
  /* User can add his own implementation to report the file name and line number,
     tex: printf("Wrong parameters value: file %s on line %d\r\n", file, line) */
  /* USER CODE END 6 */
}
#endif /* USE_FULL_ASSERT */

/************************ (C) COPYRIGHT STMicroelectronics *****END OF FILE****/
