diazmanuel/Nixie-Clock/Software/NixieClock/NixieClock.ioc

Mcu.UserName=STM32F103C8Tx
PB14.GPIO_Label=Nixie_4
PA6.GPIO_Label=Nixie_1
PB0.GPIO_Label=Nixie_DP
PB6.GPIO_Label=NixieCrl_4
PB13.GPIO_Label=Nixie_3
PB11.Signal=I2C2_SDA
PB13.Signal=GPIO_Output
PB15.Signal=GPIO_Output
PC15-OSC32_OUT.GPIO_Label=LedGreen
PD1-OSC_OUT.Signal=RCC_OSC_OUT
PA15.GPIO_Label=NixieCrl_0
PA12.Signal=GPIO_Output
PB6.Signal=GPIO_Output
PB2.Signal=GPIO_Input
PB12.GPIO_Label=Nixie_2
PB1.GPIO_Label=Nixie_LP
PA10.GPIO_Label=Nixie_0
PB7.Signal=GPIO_Output
PA8.Signal=GPIO_Output
PB7.GPIO_Label=NixieCrl_5
PB9.Signal=GPIO_Input
PB1.Signal=GPIO_Output
PA6.Signal=GPIO_Output
PA2.GPIO_Label=BL
PA10.Signal=GPIO_Output
PA15.Signal=GPIO_Output
PB5.GPIO_Label=NixieCrl_3
PC14-OSC32_IN.GPIO_Label=LedBlue
PA4.GPIO_Label=B2
PB4.Signal=GPIO_Output
PA3.Signal=GPIO_Input
PB3.GPIO_Label=NixieCrl_1
PB9.GPIO_Label=BOARD_SEL
PA9.GPIO_Label=Nixie_7
PC13-TAMPER-RTC.Signal=GPIO_Output
PA11.GPIO_Label=Nixie_9
PD0-OSC_IN.Signal=RCC_OSC_IN
PC14-OSC32_IN.Signal=GPIO_Output
PA12.GPIO_Label=Nixie_8
PA0-WKUP.GPIO_Label=Buzzer
PA0-WKUP.Signal=GPIO_Output
PA13.Signal=SYS_JTMS-SWDIO
PB8.GPIO_Label=SENSOR
PA8.GPIO_Label=Nixie_6
PA9.Signal=GPIO_Output
PC15-OSC32_OUT.Signal=GPIO_Output
PA1.Signal=GPXTI1
PB10.Signal=I2C2_SCL
PB14.Signal=GPIO_Output
PA5.Signal=GPIO_Input
PC13-TAMPER-RTC.GPIO_Label=LedRed
PB4.GPIO_Label=NixieCrl_2
PB15.GPIO_Label=Nixie_5
PA1.GPIO_Label=Alarm
PA2.Signal=GPIO_Output
PB3.Signal=GPIO_Output
PA4.Signal=GPIO_Input
PB5.Signal=GPIO_Output
PA7.GPIO_Label=NixieCrl_P
PA5.GPIO_Label=B3
PA11.Signal=GPIO_Output
PA14.Signal=SYS_JTCK-SWCLK
PB2.GPIO_Label=BOOT1
PB8.Signal=GPIO_Input
PB0.Signal=GPIO_Output
PB12.Signal=GPIO_Output
PA3.GPIO_Label=B1
PA7.Signal=GPIO_Output
