diazmanuel/Nixie-Clock/(commit log)

2019-07-19 PCB + Datasheet
    [New_configuration (1).cfg]
2020-01-02 update PCB
    [NixieClock.PrjPcb, Nixielib.PcbLib, Nixielib.SchLib, Sheet1.SchDoc, Sheet2.SchDoc, Sheet3.SchDoc]
2020-03-03 old sensor
2020-05-13 pcb + datasheets
    [Acrilico.SLDPRT, Button.SLDPRT, Iman.SLDPRT, Jack5.5x2.1.SLDPRT, NixieClock.PrjPcb, NixieClock.SLDASM, NixieClock_B1.PcbDoc, NixieClock_B1.PrjPcb]
2020-05-14 nixie tubes 3D
    [Acrilico.SLDPRT, Button.SLDPRT, Iman.SLDPRT, Jack5.5x2.1.SLDPRT, NX-IN14.SLDPRT, NX-IN3.SLDPRT, NX-SPC-IN14.SLDPRT, NX-SPC-IN3.SLDPRT]
2020-05-14 3D models
    [Acrilico.SLDPRT, Button.SLDPRT, Iman.SLDPRT, Jack5.5x2.1.SLDPRT, NX-IN14.SLDPRT, NX-IN3.SLDPRT, NX-SPC-IN14.SLDPRT, NX-SPC-IN14.STL]
2020-05-14 PCB + outputs
    [Acrilico.SLDPRT, Acrylic.SLDPRT, Box.SLDPRT, Button.SLDPRT, Iman.SLDPRT, Jack5.5x2.1.SLDPRT, Leg.SLDPRT, Magnet.SLDPRT]
2020-05-15 PCB 3DModels
    [NixieClock_B1.PrjPcb, NixieClock_B2.PrjPcb]
2020-05-15 nixie clock model
    [Box.SLDPRT, Leg.SLDPRT, Nixie-Board-1.SLDPRT, NixieClock_B1.x_t]
2020-12-31 white balance
    [NixieClock_B1.PrjPcb, NixieClock_B2.PrjPcb, nixie_light.SchDoc, white balance.xlsx]
2021-05-01 footprint led
    [Acrylic.SLDPRT, Box.SLDPRT, Button.SLDPRT, Jack5.5x2.1.SLDPRT, Magnet.SLDPRT, NX-IN14.SLDPRT, NX-IN3.SLDPRT, NX-SPC-IN14.SLDPRT]
2021-05-11 cap en entrada de fuente HV
    [NixieClock_B1.PrjPcb, NixieClock_B2.PrjPcb, nixie_peripherals.SchDoc, nixie_power.SchDoc]
2021-05-13 datasheets + cambio de holder 3v3
    [NixieClock_B1.GBL, NixieClock_B1.GBO, NixieClock_B1.GBP, NixieClock_B1.GBS, NixieClock_B1.GKO, NixieClock_B1.GM1, NixieClock_B1.GTL, NixieClock_B1.GTO]
2021-06-10 empiezan cambios en software
    [nixie_peripherals.SchDoc]
2021-06-12 update gerbers
    [NixieClock_B1.PrjPcb, NixieClock_B1.xls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]
