diazmanuel/Nixie-Clock/(notices)

Notices in the files:
Software/NixieClock/Src/main.c:
Copyright (c) 2019 STMicroelectronics International N.V.
All rights reserved.
